Kightbl/FACTR_xArm7/hardware/3D_print_files/factr_teleop_gripper_trigger.STL

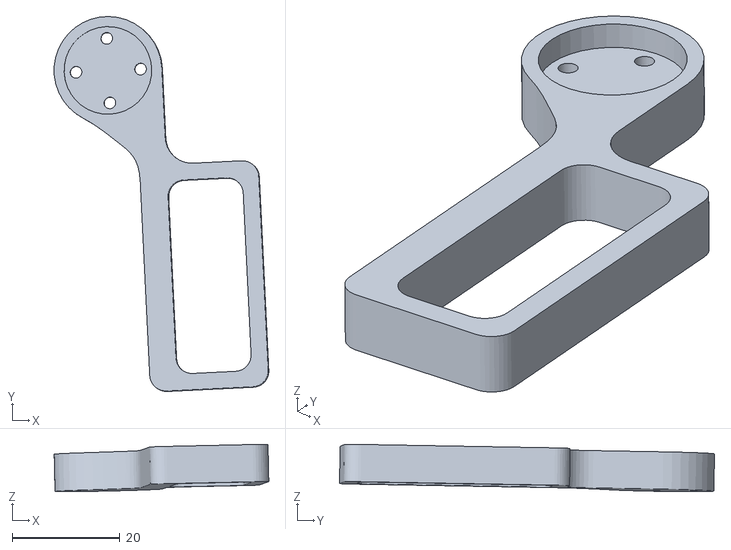
[picture p1: CAD file, 2026-07-21]
hardware/3D_print_files/factr_teleop_gripper_trigger.STL
39.9 x 69.6 x 8.79
