Kightbl/FACTR_xArm7/hardware/CAD/factr_teleop_xarm7_l1.SLDPRT

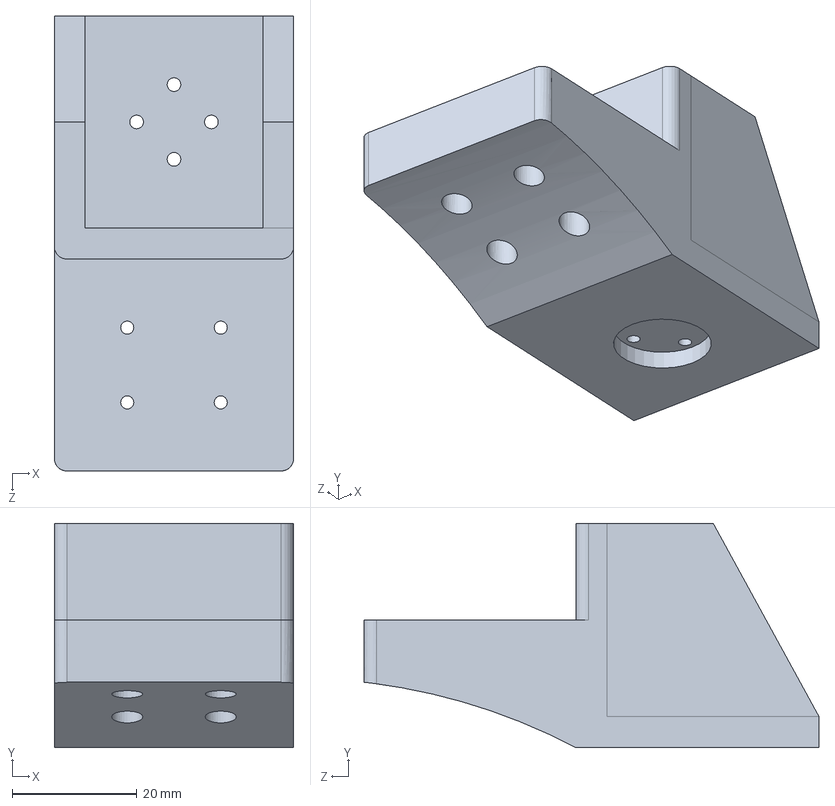
[picture p2: CAD file, 2026-07-21]
hardware/CAD/factr_teleop_xarm7_l1.SLDPRT
38.4 x 36.0 x 73.0 mm
