Kightbl/FACTR_xArm7/hardware/CAD/Gripper Leader/factr_teleop_gripper_trigger.SLDPRT

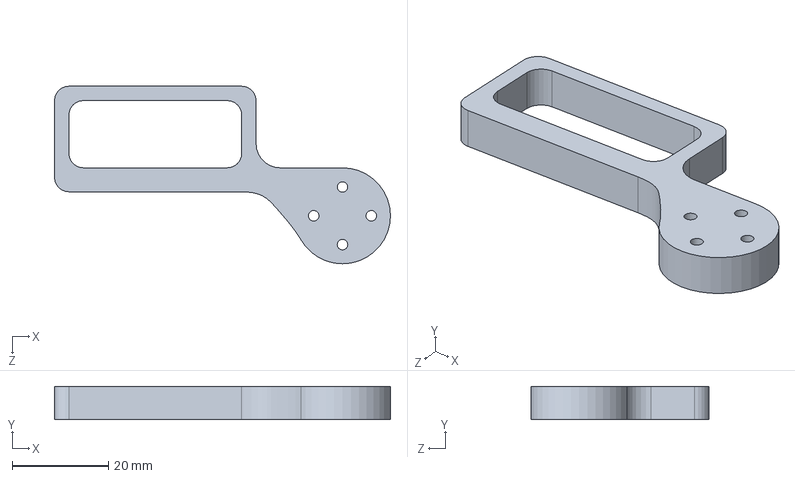
[picture p3: CAD file, 2026-07-21]
hardware/CAD/Gripper Leader/factr_teleop_gripper_trigger.SLDPRT
70.0 x 6.90 x 37.0 mm
