Kightbl/FACTR_xArm7/hardware/3D_print_files/factr_teleop_xarm7_base.STL

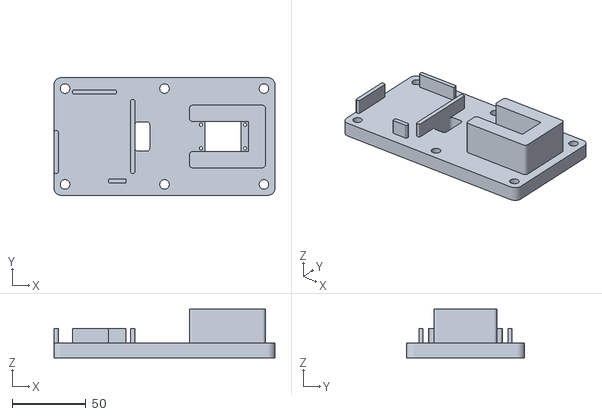
[picture p4: CAD file, 2026-07-21]
hardware/3D_print_files/factr_teleop_xarm7_base.STL
150.0 x 80.0 x 33.0
