Kightbl/FACTR_xArm7/hardware/CAD/factr_teleop_xarm7_l5.SLDPRT

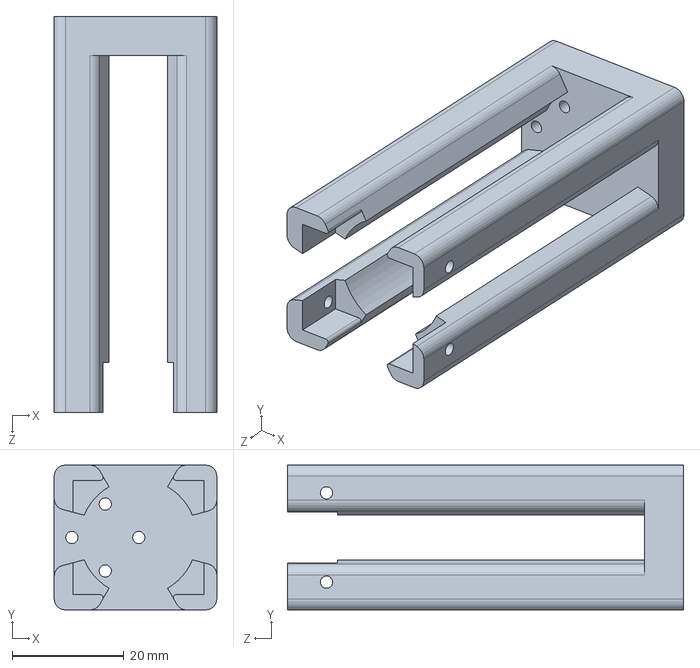
[picture p5: CAD file, 2026-07-21]
hardware/CAD/factr_teleop_xarm7_l5.SLDPRT
29.2 x 26.0 x 71.0 mm
