Kightbl/FACTR_xArm7/hardware/3D_print_files/factr_teleop_gripper_leader_handle.STL

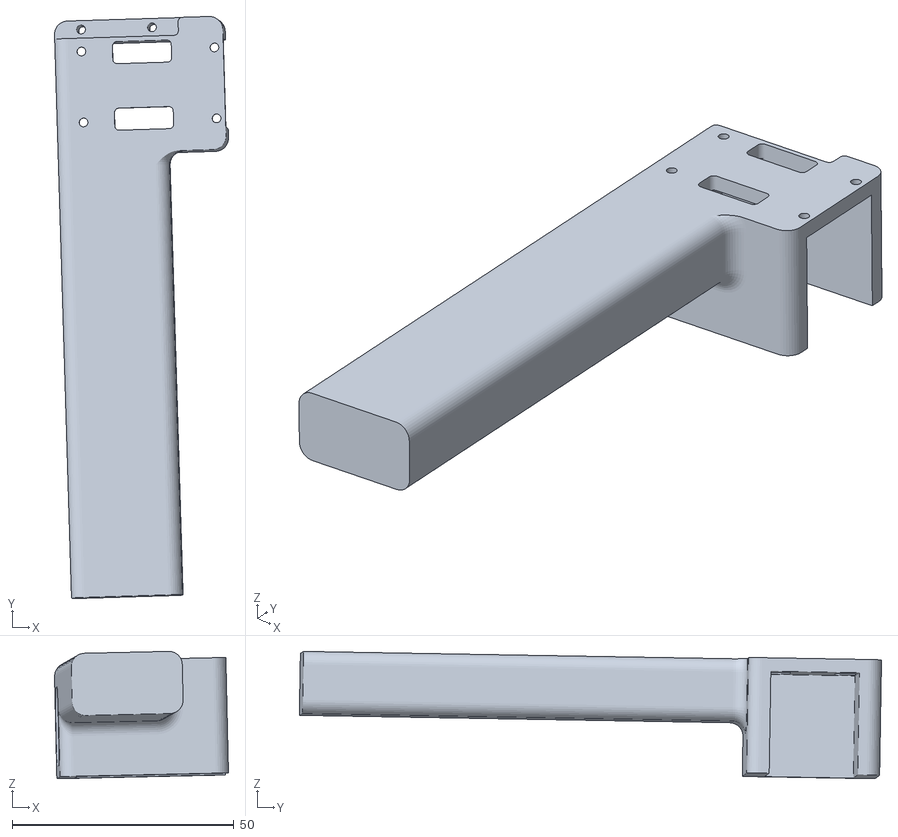
[picture p6: CAD file, 2026-07-21]
hardware/3D_print_files/factr_teleop_gripper_leader_handle.STL
39.2 x 131.2 x 28.7
