Kightbl/FACTR_xArm7/hardware/CAD/factr_teleop_xarm7_l3.SLDPRT

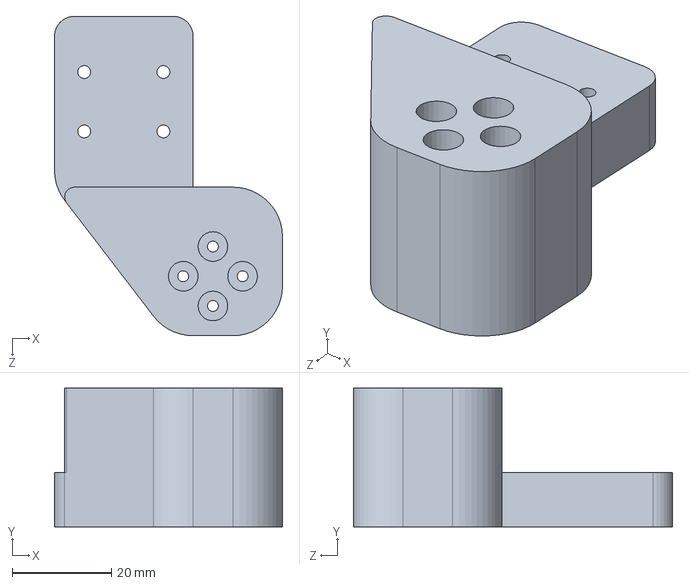
[picture p7: CAD file, 2026-07-21]
hardware/CAD/factr_teleop_xarm7_l3.SLDPRT
46.0 x 28.0 x 64.5 mm
