Kightbl/FACTR_xArm7/hardware/CAD/Gripper Leader/factr_teleop_gripper_leader_handle.SLDPRT

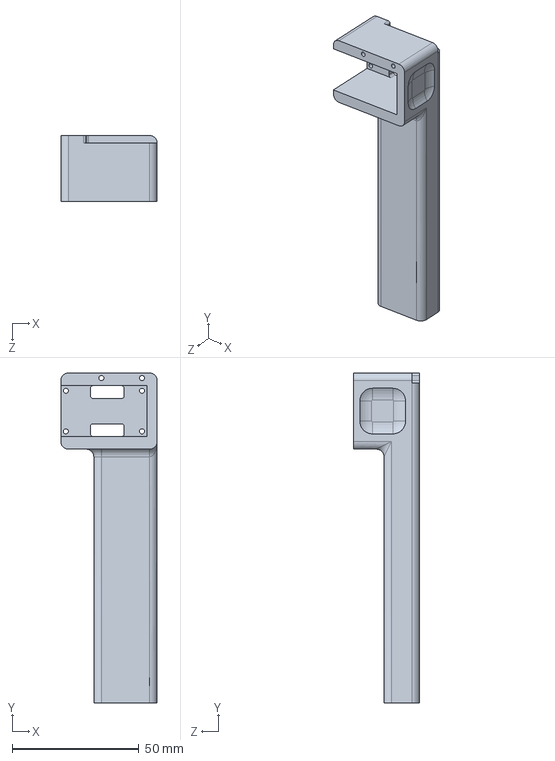
[picture p8: CAD file, 2026-07-21]
hardware/CAD/Gripper Leader/factr_teleop_gripper_leader_handle.SLDPRT
38.0 x 130.0 x 26.0 mm
