Kightbl/FACTR_xArm7/hardware/CAD/Servos/XM330_motor_frame.SLDPRT

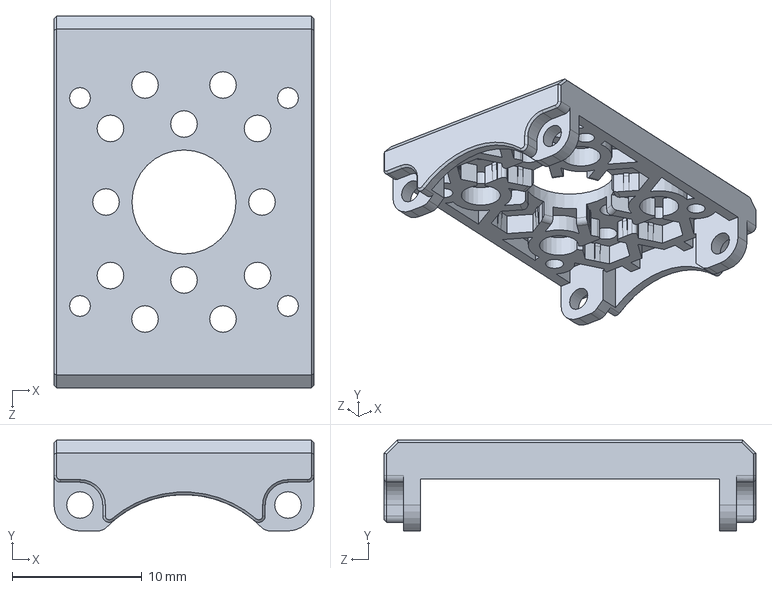
[picture p9: CAD file, 2026-07-21]
hardware/CAD/Servos/XM330_motor_frame.SLDPRT
20.0 x 7.00 x 28.6 mm
