Kightbl/FACTR_xArm7/hardware/CAD/FACTR_teleop_xArm7.STEP

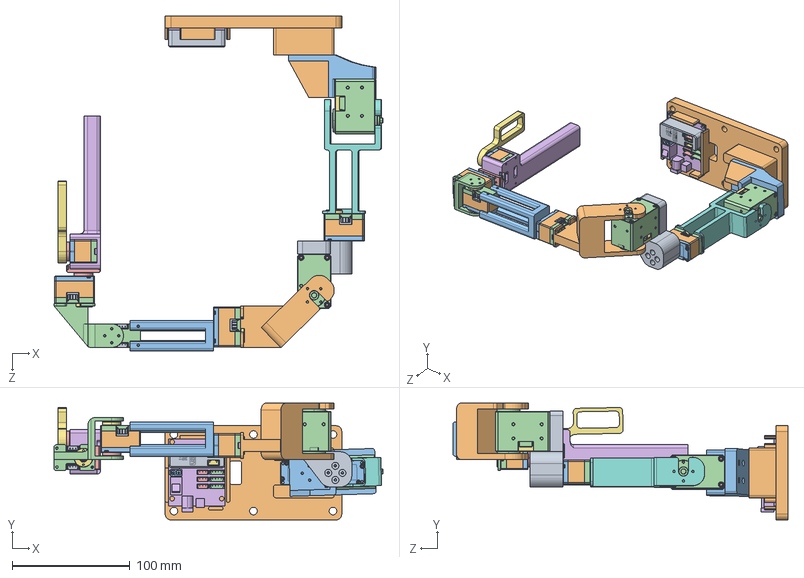
[picture p10: CAD file, 2026-07-21]
hardware/CAD/FACTR_teleop_xArm7.STEP
279.3 x 99.2 x 284.4 mm
factr_teleop_xarm7_base
39281023.prt.stp
JST-B4B-EH-A.PRT.1.stp x 3
JST-B3B-EH-A.PRT.1.stp x 3
Board.stp
JST-B3B-EH-A.PRT.stp
JST-B4B-EH-A.PRT.stp
JST-B4B-PH-K-S.PRT.stp
MICRO_USB_2_0_CONNECTOR__AB_REC.PRT.stp
PCB_U2D2.PRT.stp
U2D2_CASING.PRT.stp
DC15_A01_CASE_M_DUMMY.stp x 6
DC15_A01_CASE_F_DUMMY.stp x 6
DC15_A01_CASE_B_DUMMY.stp x 6
DC15_A01_HORN_DUMMY.stp x 6
DC15_A01_LED_CAP2_DUMMY.stp x 6
PHS_1_7X20_5_DC10.stp x 24
BTS2_M2_6X8.stp x 12
DC15_A01_HORN_IDLE2_DUMMY.stp x 6
DC15_A01_IDLE_CAP_DUMMY.stp x 6
B3B-EH.stp x 12
factr_teleop_xarm7_l1
DUMMY_DC12.stp x 2
WBH_M2_5X12.stp x 16
DC12_A01_SPACER_RING_1.stp x 16
DC12_A01_CVR_CABLE_5.stp x 2
factr_teleop_xarm7_l2_零件名称
factr_teleop_xarm7_l3_零件名称
factr_teleop_xarm7_l4_零件名称
factr_teleop_xarm7_l5_零件名称
factr_teleop_xarm7_l6_零件名称
XM330_motor_frame_默认
factr_teleop_gripper_leader_handle
factr_teleop_gripper_trigger
