Kightbl/FACTR_xArm7/hardware/CAD/factr_teleop_xarm7_l6.SLDPRT

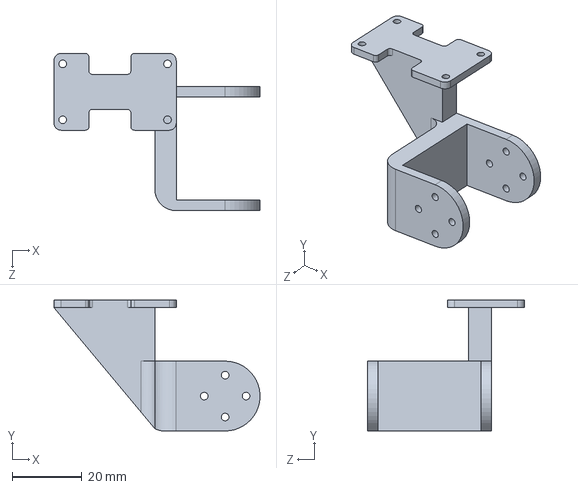
[picture p11: CAD file, 2026-07-21]
hardware/CAD/factr_teleop_xarm7_l6.SLDPRT
59.0 x 37.5 x 45.0 mm
