Kightbl/FACTR_xArm7/hardware/CAD/factr_teleop_xarm7_l4.SLDPRT

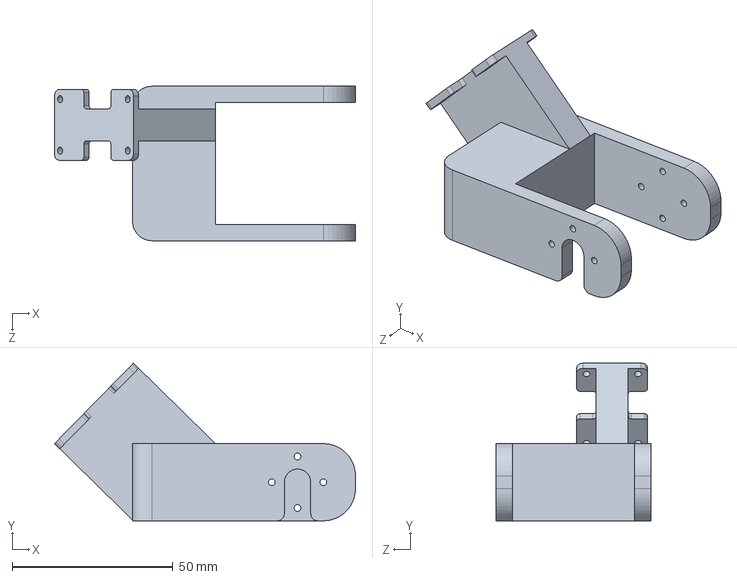
[picture p12: CAD file, 2026-07-21]
hardware/CAD/factr_teleop_xarm7_l4.SLDPRT
93.5 x 49.0 x 48.0 mm
