Kightbl/FACTR_xArm7/hardware/CAD/factr_teleop_xarm7_l2.SLDPRT

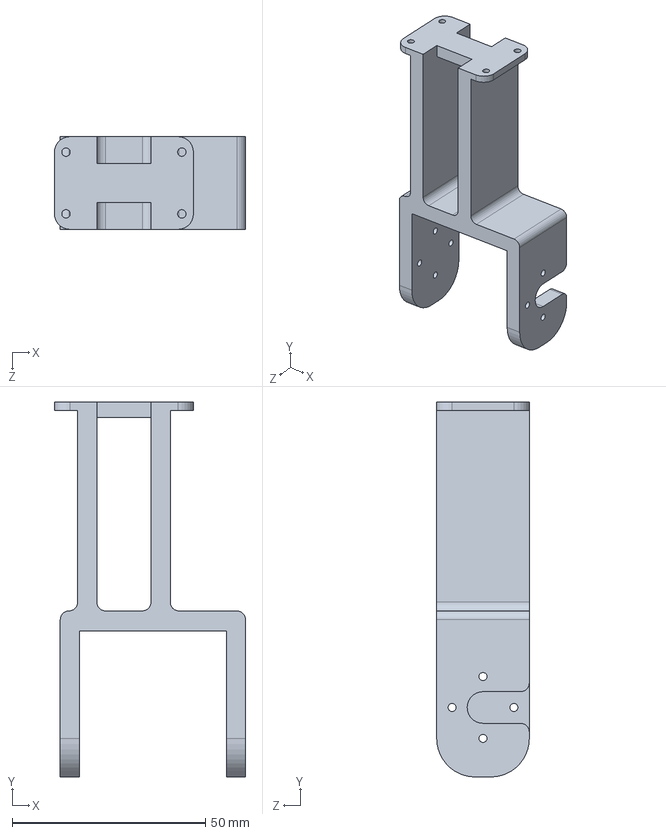
[picture p13: CAD file, 2026-07-21]
hardware/CAD/factr_teleop_xarm7_l2.SLDPRT
49.5 x 97.1 x 24.0 mm
