Kightbl/FACTR_xArm7/hardware/CAD/Base/U2D2_power_hub_board.SLDASM

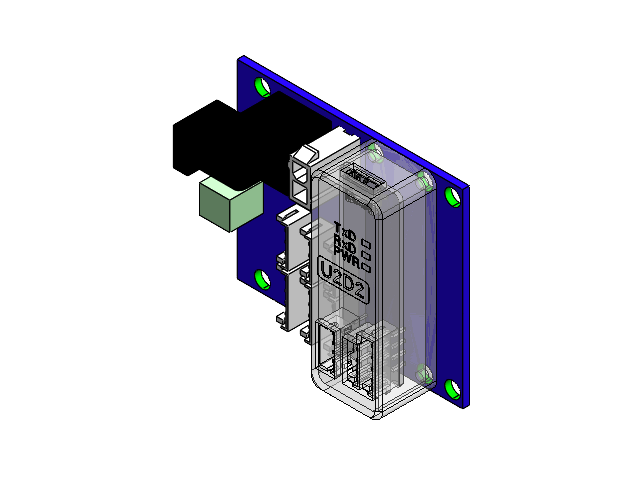
[picture p14: CAD file, 2026-07-21]
hardware/CAD/Base/U2D2_power_hub_board.SLDASM
39281023.prt.stp
JST-B4B-EH-A.PRT.1.stp x 3
JST-B3B-EH-A.PRT.1.stp x 3
Board.stp
JST-B3B-EH-A.PRT.stp
JST-B4B-EH-A.PRT.stp
JST-B4B-PH-K-S.PRT.stp
MICRO_USB_2_0_CONNECTOR__AB_REC.PRT.stp
PCB_U2D2.PRT.stp
U2D2_CASING.PRT.stp
