Kightbl/FACTR_xArm7/hardware/CAD/Servos/XM430.SLDASM

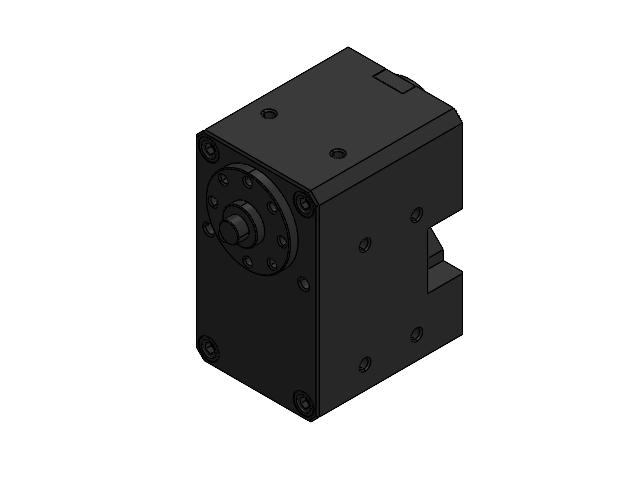
[picture p15: CAD file, 2026-07-21]
hardware/CAD/Servos/XM430.SLDASM
DUMMY_DC12.stp
WBH_M2_5X12.stp x 8
DC12_A01_SPACER_RING_1.stp x 8
DC12_A01_CVR_CABLE_5.stp
