Kightbl/FACTR_xArm7/hardware/CAD/Gripper Leader/factr_teleop_gripper_leader.SLDASM

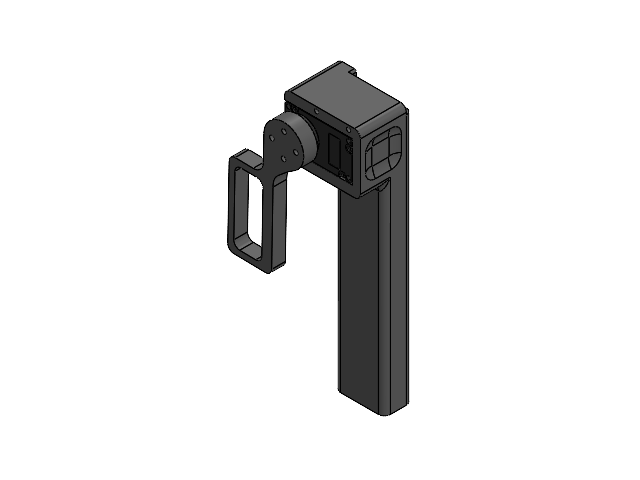
[picture p16: CAD file, 2026-07-21]
hardware/CAD/Gripper Leader/factr_teleop_gripper_leader.SLDASM
factr_teleop_gripper_leader_handle
DC15_A01_CASE_M_DUMMY.stp
DC15_A01_CASE_F_DUMMY.stp
DC15_A01_CASE_B_DUMMY.stp
DC15_A01_HORN_DUMMY.stp
DC15_A01_LED_CAP2_DUMMY.stp
PHS_1_7X20_5_DC10.stp x 4
BTS2_M2_6X8.stp
B3B-EH.stp x 2
factr_teleop_gripper_trigger
