Kightbl/FACTR_xArm7/(list of files, cad)

Other CAD files:
hardware/CAD/Base/factr_teleop_xarm7_base.SLDPRT
hardware/3D_print_files/factr_teleop_xarm7_l1.STL
hardware/3D_print_files/factr_teleop_xarm7_l2.STL
hardware/3D_print_files/factr_teleop_xarm7_l3.STL
hardware/3D_print_files/factr_teleop_xarm7_l4.STL
hardware/3D_print_files/factr_teleop_xarm7_l5.STL
hardware/3D_print_files/factr_teleop_xarm7_l6.STL
hardware/CAD/FACTR_teleop_xArm7.SLDASM
